schlae/gvpsimm/README.md

# GVP 64-pin SIMM modules

This repository contains reproduction SIMMs for GVP (Great Valley Products)
Amiga accelerator cards. Select a link below to pick a particular version.

[4MB version](4MB/README.md)

[16MB version](16MB/README.md)
