schlae/gvpsimm/4MB/gvpsimm.pdf

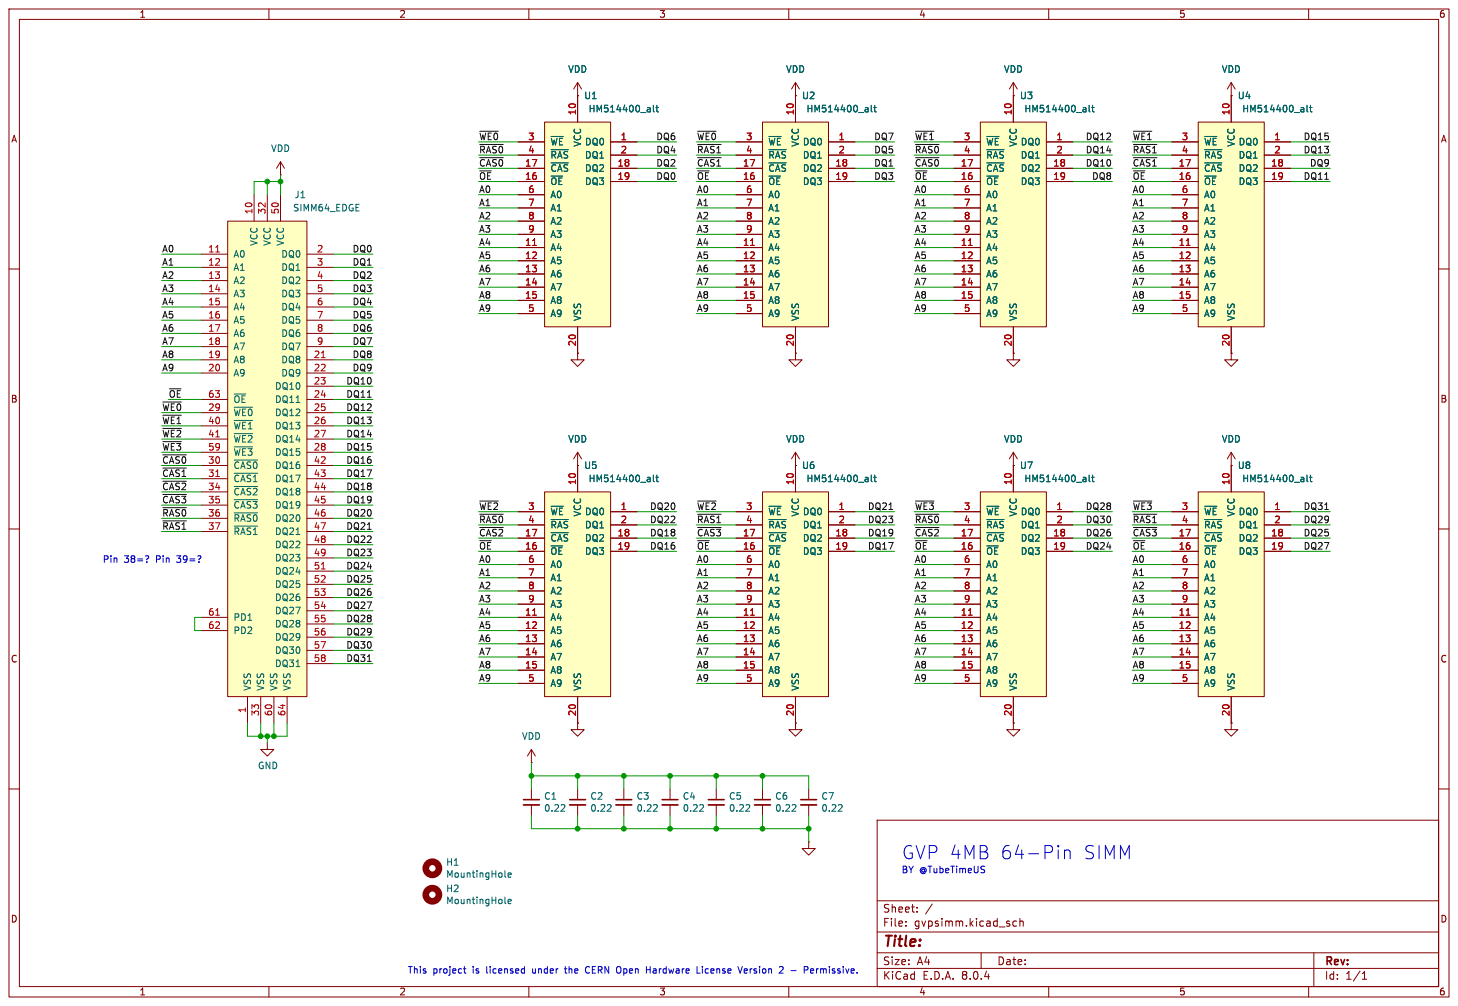
[picture p2: page 1]

Id: 1/1 Title: File: gvpsimm.kicad_sch Sheet: /
