schlae/gvpsimm/16MB/gvpsimm16.kicad_pcb

## KiCad design 16MB/gvpsimm16.kicad_pcb (2025-04-29)

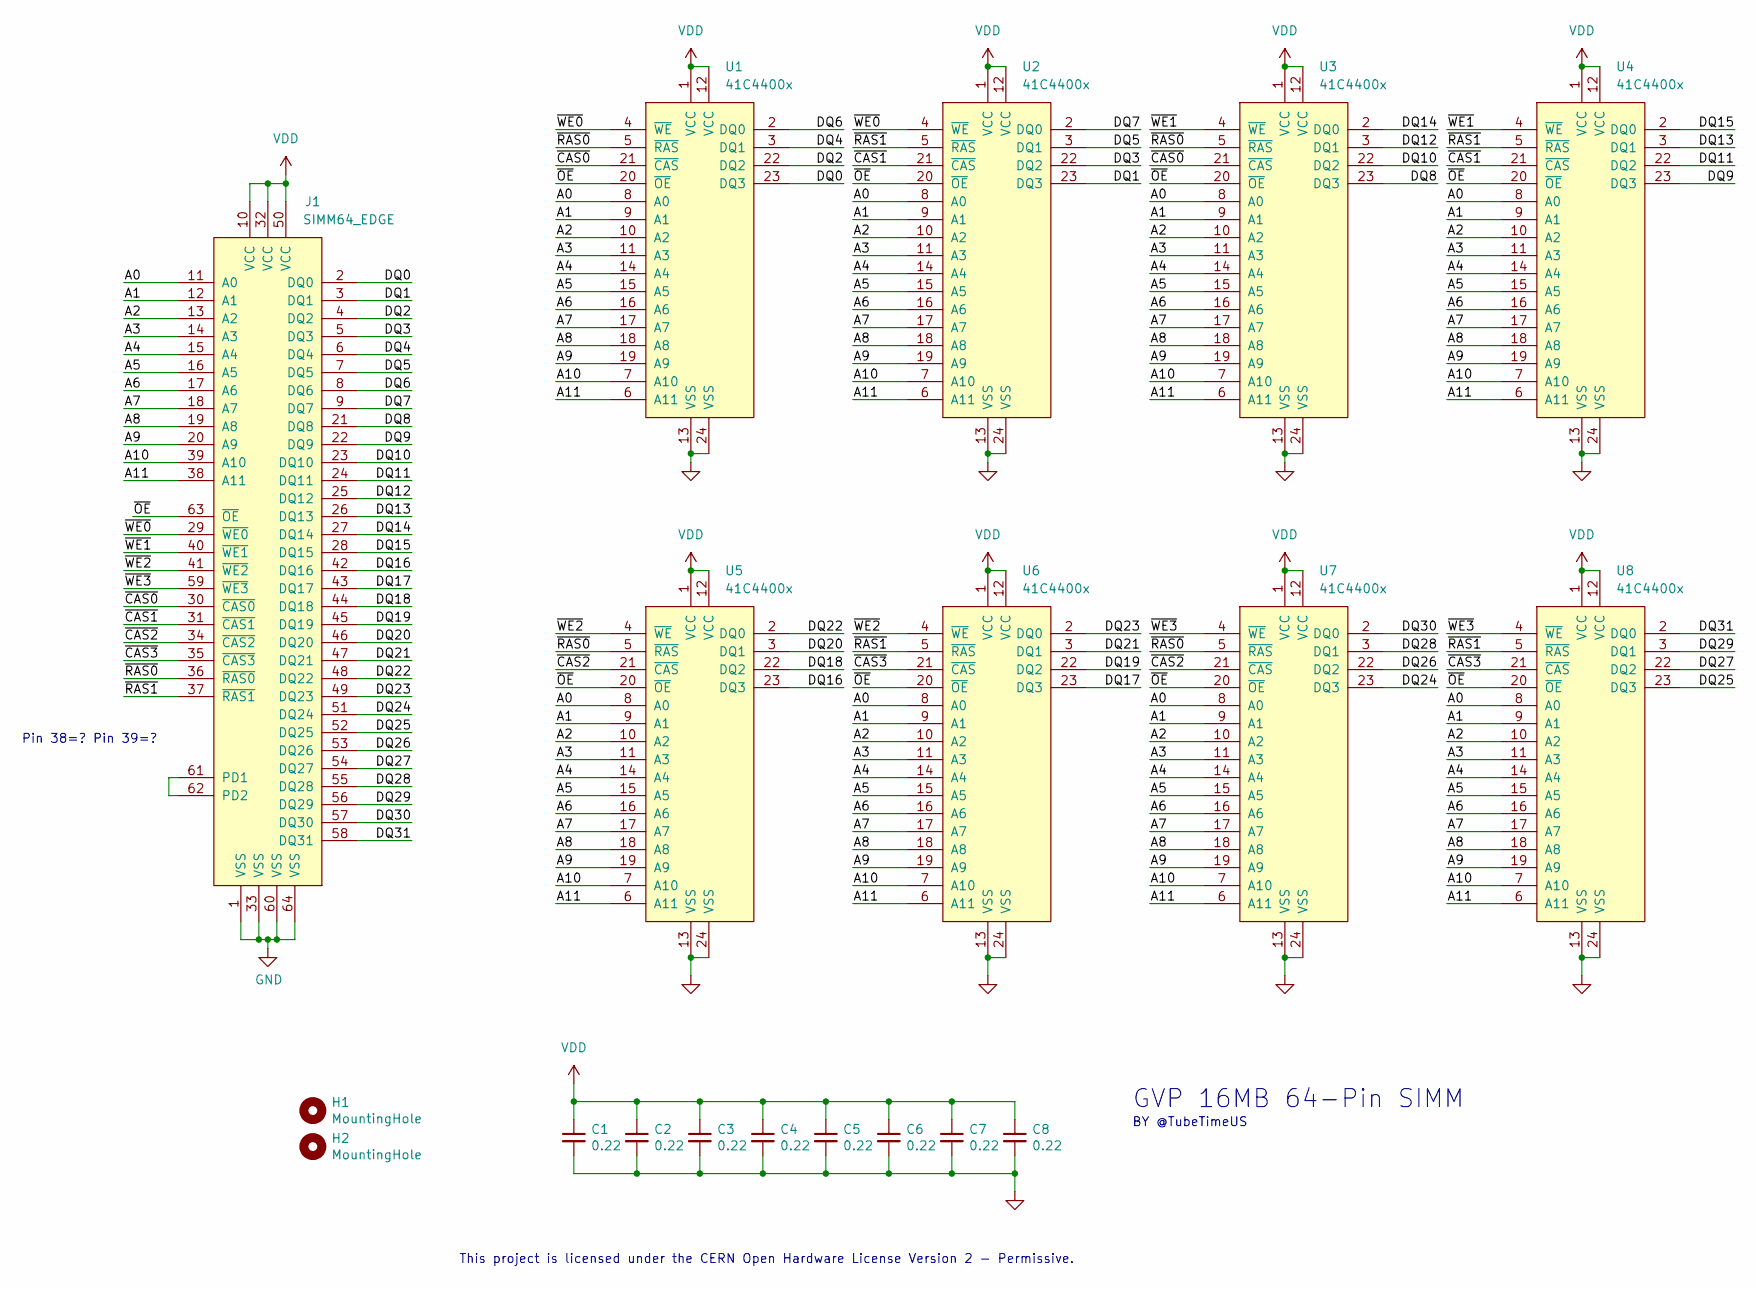
[picture p3: schematic gvpsimm16.kicad_sch]

Parts:
C1, C2, C3, C4, C5, C6, C7, C8: 0.22; CAPC1608X100
H1, H2: MountingHole; MH_125
J1: SIMM64_EDGE; EDGE_SIMM_64_127
U1, U2, U3, U4, U5, U6, U7, U8: 41C4400x; SOJ127P851X356-24

Connections:
/A0: J1.11 (A0), U1.8 (A0), U2.8 (A0), U3.8 (A0), U4.8 (A0), U5.8 (A0), U6.8 (A0), U7.8 (A0), U8.8 (A0)
/A1: J1.12 (A1), U1.9 (A1), U2.9 (A1), U3.9 (A1), U4.9 (A1), U5.9 (A1), U6.9 (A1), U7.9 (A1), U8.9 (A1)
/A2: J1.13 (A2), U1.10 (A2), U2.10 (A2), U3.10 (A2), U4.10 (A2), U5.10 (A2), U6.10 (A2), U7.10 (A2), U8.10 (A2)
/A3: J1.14 (A3), U1.11 (A3), U2.11 (A3), U3.11 (A3), U4.11 (A3), U5.11 (A3), U6.11 (A3), U7.11 (A3), U8.11 (A3)
/A4: J1.15 (A4), U1.14 (A4), U2.14 (A4), U3.14 (A4), U4.14 (A4), U5.14 (A4), U6.14 (A4), U7.14 (A4), U8.14 (A4)
/A5: J1.16 (A5), U1.15 (A5), U2.15 (A5), U3.15 (A5), U4.15 (A5), U5.15 (A5), U6.15 (A5), U7.15 (A5), U8.15 (A5)
/A6: J1.17 (A6), U1.16 (A6), U2.16 (A6), U3.16 (A6), U4.16 (A6), U5.16 (A6), U6.16 (A6), U7.16 (A6), U8.16 (A6)
/A7: J1.18 (A7), U1.17 (A7), U2.17 (A7), U3.17 (A7), U4.17 (A7), U5.17 (A7), U6.17 (A7), U7.17 (A7), U8.17 (A7)
/A8: J1.19 (A8), U1.18 (A8), U2.18 (A8), U3.18 (A8), U4.18 (A8), U5.18 (A8), U6.18 (A8), U7.18 (A8), U8.18 (A8)
/A9: J1.20 (A9), U1.19 (A9), U2.19 (A9), U3.19 (A9), U4.19 (A9), U5.19 (A9), U6.19 (A9), U7.19 (A9), U8.19 (A9)
/A10: J1.39 (A10), U1.7 (A10), U2.7 (A10), U3.7 (A10), U4.7 (A10), U5.7 (A10), U6.7 (A10), U7.7 (A10), U8.7 (A10)
/A11: J1.38 (A11), U1.6 (A11), U2.6 (A11), U3.6 (A11), U4.6 (A11), U5.6 (A11), U6.6 (A11), U7.6 (A11), U8.6 (A11)
/DQ0: J1.2 (DQ0), U1.23 (DQ3)
/DQ1: J1.3 (DQ1), U2.23 (DQ3)
/DQ2: J1.4 (DQ2), U1.22 (DQ2)
/DQ3: J1.5 (DQ3), U2.22 (DQ2)
/DQ4: J1.6 (DQ4), U1.3 (DQ1)
/DQ5: J1.7 (DQ5), U2.3 (DQ1)
/DQ6: J1.8 (DQ6), U1.2 (DQ0)
/DQ7: J1.9 (DQ7), U2.2 (DQ0)
/DQ8: J1.21 (DQ8), U3.23 (DQ3)
/DQ9: J1.22 (DQ9), U4.23 (DQ3)
/DQ10: J1.23 (DQ10), U3.22 (DQ2)
/DQ11: J1.24 (DQ11), U4.22 (DQ2)
/DQ12: J1.25 (DQ12), U3.3 (DQ1)
/DQ13: J1.26 (DQ13), U4.3 (DQ1)
/DQ14: J1.27 (DQ14), U3.2 (DQ0)
/DQ15: J1.28 (DQ15), U4.2 (DQ0)
/DQ16: J1.42 (DQ16), U5.23 (DQ3)
/DQ17: J1.43 (DQ17), U6.23 (DQ3)
/DQ18: J1.44 (DQ18), U5.22 (DQ2)
/DQ19: J1.45 (DQ19), U6.22 (DQ2)
/DQ20: J1.46 (DQ20), U5.3 (DQ1)
/DQ21: J1.47 (DQ21), U6.3 (DQ1)
/DQ22: J1.48 (DQ22), U5.2 (DQ0)
/DQ23: J1.49 (DQ23), U6.2 (DQ0)
/DQ24: J1.51 (DQ24), U7.23 (DQ3)
/DQ25: J1.52 (DQ25), U8.23 (DQ3)
/DQ26: J1.53 (DQ26), U7.22 (DQ2)
/DQ27: J1.54 (DQ27), U8.22 (DQ2)
/DQ28: J1.55 (DQ28), U7.3 (DQ1)
/DQ29: J1.56 (DQ29), U8.3 (DQ1)
/DQ30: J1.57 (DQ30), U7.2 (DQ0)
/DQ31: J1.58 (DQ31), U8.2 (DQ0)
/~CAS0: J1.30 (~CAS0), U1.21 (~CAS), U3.21 (~CAS)
/~CAS1: J1.31 (~CAS1), U2.21 (~CAS), U4.21 (~CAS)
/~CAS2: J1.34 (~CAS2), U5.21 (~CAS), U7.21 (~CAS)
/~CAS3: J1.35 (~CAS3), U6.21 (~CAS), U8.21 (~CAS)
/~OE: J1.63 (~OE), U1.20 (~OE), U2.20 (~OE), U3.20 (~OE), U4.20 (~OE), U5.20 (~OE), U6.20 (~OE), U7.20 (~OE), U8.20 (~OE)
/~RAS0: J1.36 (~RAS0), U1.5 (~RAS), U3.5 (~RAS), U5.5 (~RAS), U7.5 (~RAS)
/~RAS1: J1.37 (~RAS1), U2.5 (~RAS), U4.5 (~RAS), U6.5 (~RAS), U8.5 (~RAS)
/~WE0: J1.29 (~WE0), U1.4 (~WE), U2.4 (~WE)
/~WE1: J1.40 (~WE1), U3.4 (~WE), U4.4 (~WE)
/~WE2: J1.41 (~WE2), U5.4 (~WE), U6.4 (~WE)
/~WE3: J1.59 (~WE3), U7.4 (~WE), U8.4 (~WE)
GND: C1.2, C2.2, C3.2, C4.2, C5.2, C6.2, C7.2, C8.2, J1.1 (VSS), J1.33 (VSS), J1.60 (VSS), J1.64 (VSS), U1.13 (VSS), U1.24 (VSS), U2.13 (VSS), U2.24 (VSS), U3.13 (VSS), U3.24 (VSS), U4.13 (VSS), U4.24 (VSS), U5.13 (VSS), U5.24 (VSS), U6.13 (VSS), U6.24 (VSS), U7.13 (VSS), U7.24 (VSS), U8.13 (VSS), U8.24 (VSS)
unnamed: J1.61 (PD1), J1.62 (PD2)
VDD: C1.1, C2.1, C3.1, C4.1, C5.1, C6.1, C7.1, C8.1, J1.10 (VCC), J1.32 (VCC), J1.50 (VCC), U1.1 (VCC), U1.12 (VCC), U2.1 (VCC), U2.12 (VCC), U3.1 (VCC), U3.12 (VCC), U4.1 (VCC), U4.12 (VCC), U5.1 (VCC), U5.12 (VCC), U6.1 (VCC), U6.12 (VCC), U7.1 (VCC), U7.12 (VCC), U8.1 (VCC), U8.12 (VCC)

Notes on the sheet:
Pin 38=? Pin 39=?
BY @TubeTimeUS
This project is licensed under the CERN Open Hardware License Version 2 - Permissive.
GVP 16MB 64-Pin SIMM

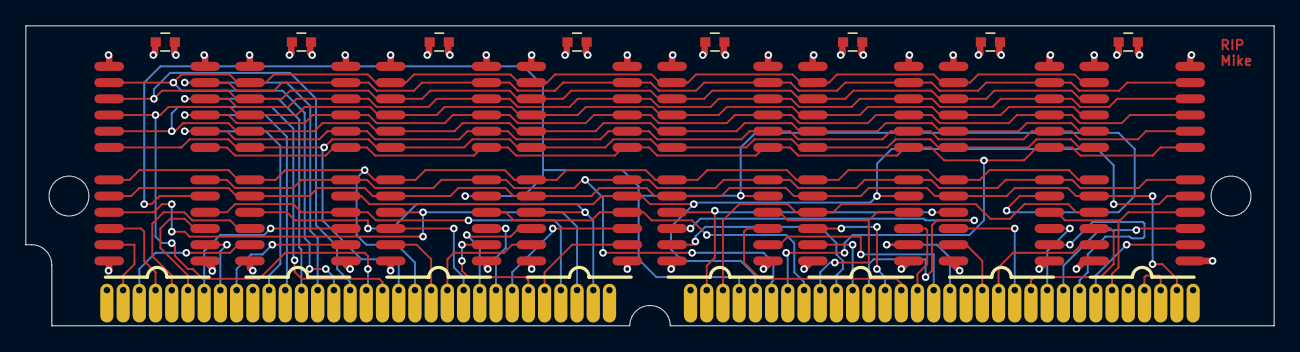
[picture p4: board gvpsimm16.kicad_pcb from above]

Board: 4 copper layers, 97.8 x 23.5 mm, 19 parts (0 on the bottom side), 58 nets.
