schlae/gvpsimm/4MB/gvpsimm.kicad_pcb

## KiCad design 4MB/gvpsimm.kicad_pcb (2025-04-29)

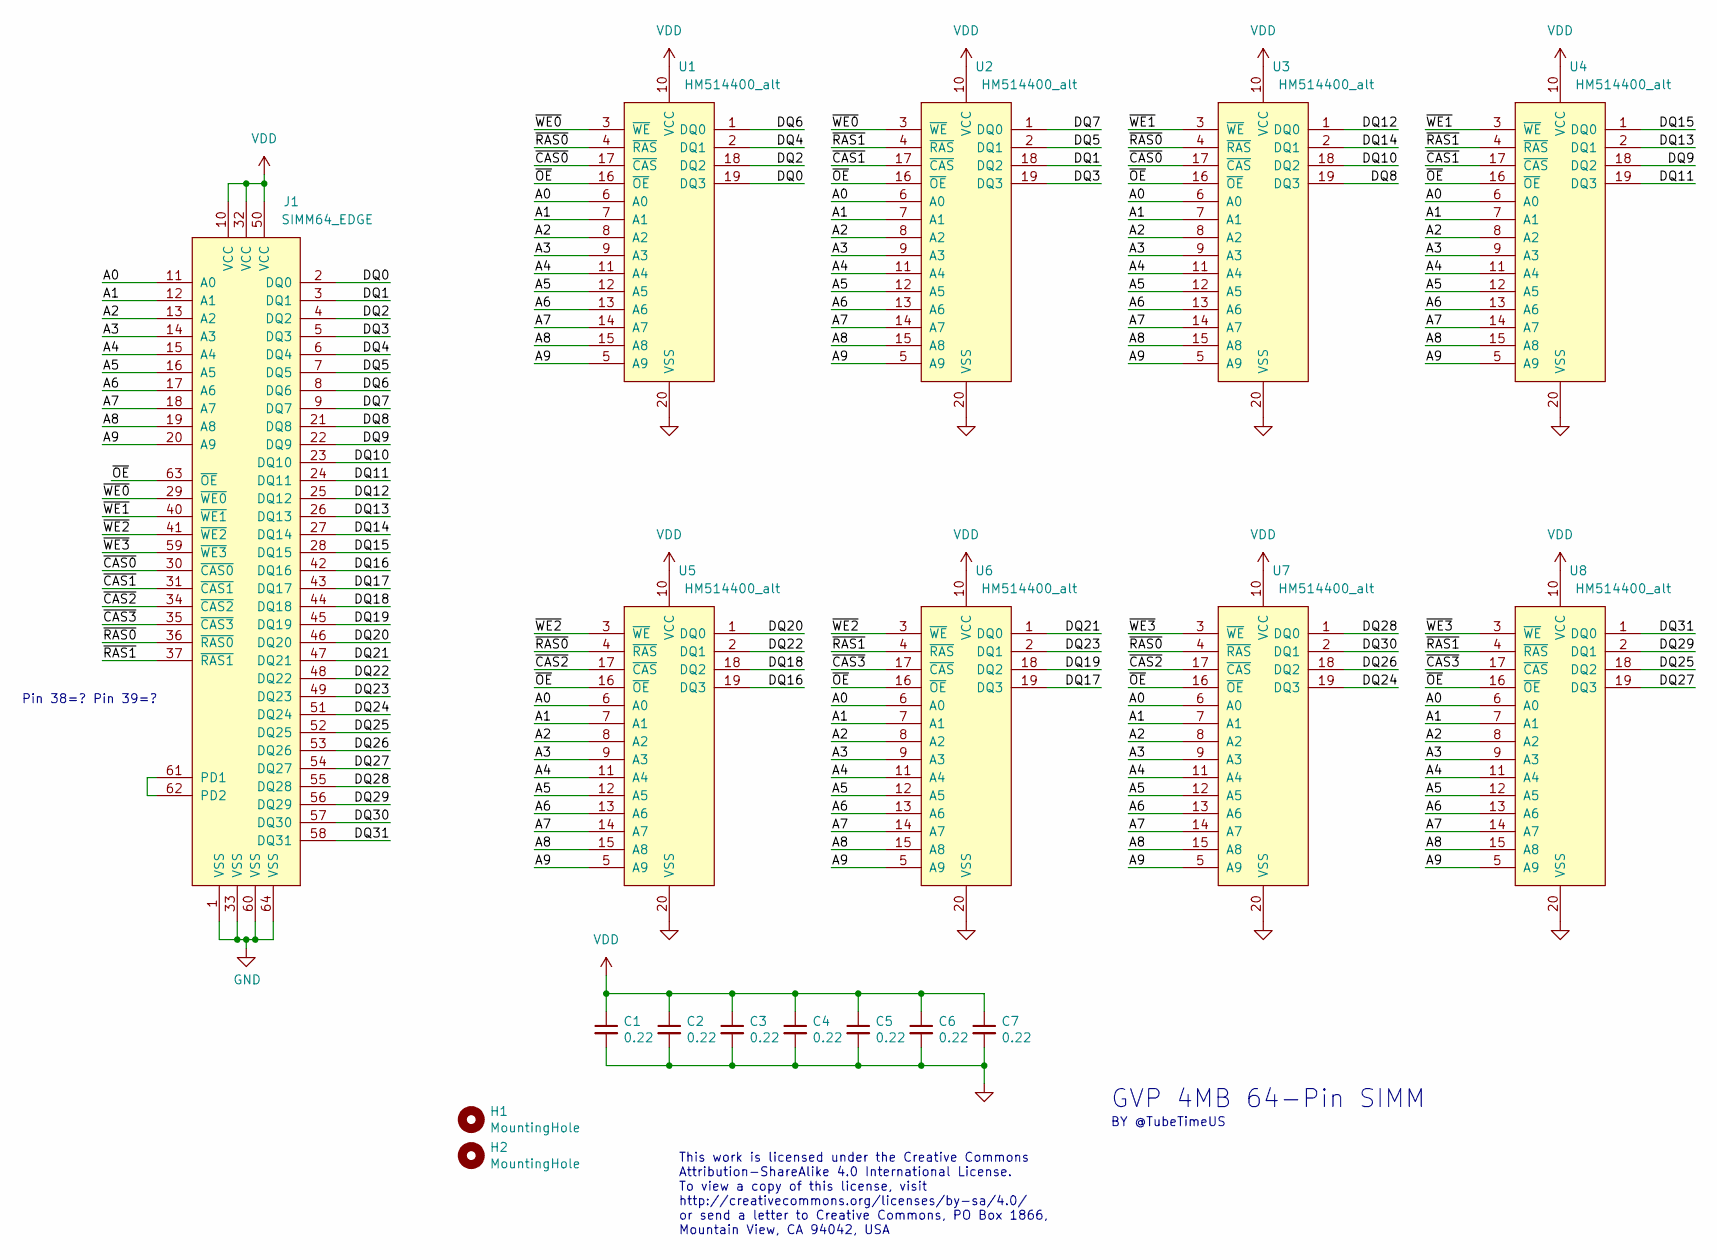
[picture p5: schematic gvpsimm.kicad_sch]

Parts:
C1, C2, C3, C4, C5, C6, C7: 0.22; CAPC1608X100
H1, H2: MountingHole; MH_125
J1: SIMM64_EDGE; EDGE_SIMM_64_127
U1, U2, U3, U4, U5, U6, U7, U8: HM514400_alt; SOJ127P851X356-20_alt; MPN HM514400CS-6 OR EQUIV

Connections:
/A0: J1.11 (A0), U1.6 (A0), U2.6 (A0), U3.6 (A0), U4.6 (A0), U5.6 (A0), U6.6 (A0), U7.6 (A0), U8.6 (A0)
/A1: J1.12 (A1), U1.7 (A1), U2.7 (A1), U3.7 (A1), U4.7 (A1), U5.7 (A1), U6.7 (A1), U7.7 (A1), U8.7 (A1)
/A2: J1.13 (A2), U1.8 (A2), U2.8 (A2), U3.8 (A2), U4.8 (A2), U5.8 (A2), U6.8 (A2), U7.8 (A2), U8.8 (A2)
/A3: J1.14 (A3), U1.9 (A3), U2.9 (A3), U3.9 (A3), U4.9 (A3), U5.9 (A3), U6.9 (A3), U7.9 (A3), U8.9 (A3)
/A4: J1.15 (A4), U1.11 (A4), U2.11 (A4), U3.11 (A4), U4.11 (A4), U5.11 (A4), U6.11 (A4), U7.11 (A4), U8.11 (A4)
/A5: J1.16 (A5), U1.12 (A5), U2.12 (A5), U3.12 (A5), U4.12 (A5), U5.12 (A5), U6.12 (A5), U7.12 (A5), U8.12 (A5)
/A6: J1.17 (A6), U1.13 (A6), U2.13 (A6), U3.13 (A6), U4.13 (A6), U5.13 (A6), U6.13 (A6), U7.13 (A6), U8.13 (A6)
/A7: J1.18 (A7), U1.14 (A7), U2.14 (A7), U3.14 (A7), U4.14 (A7), U5.14 (A7), U6.14 (A7), U7.14 (A7), U8.14 (A7)
/A8: J1.19 (A8), U1.15 (A8), U2.15 (A8), U3.15 (A8), U4.15 (A8), U5.15 (A8), U6.15 (A8), U7.15 (A8), U8.15 (A8)
/A9: J1.20 (A9), U1.5 (A9), U2.5 (A9), U3.5 (A9), U4.5 (A9), U5.5 (A9), U6.5 (A9), U7.5 (A9), U8.5 (A9)
/DQ0: J1.2 (DQ0), U1.19 (DQ3)
/DQ1: J1.3 (DQ1), U2.18 (DQ2)
/DQ2: J1.4 (DQ2), U1.18 (DQ2)
/DQ3: J1.5 (DQ3), U2.19 (DQ3)
/DQ4: J1.6 (DQ4), U1.2 (DQ1)
/DQ5: J1.7 (DQ5), U2.2 (DQ1)
/DQ6: J1.8 (DQ6), U1.1 (DQ0)
/DQ7: J1.9 (DQ7), U2.1 (DQ0)
/DQ8: J1.21 (DQ8), U3.19 (DQ3)
/DQ9: J1.22 (DQ9), U4.18 (DQ2)
/DQ10: J1.23 (DQ10), U3.18 (DQ2)
/DQ11: J1.24 (DQ11), U4.19 (DQ3)
/DQ12: J1.25 (DQ12), U3.1 (DQ0)
/DQ13: J1.26 (DQ13), U4.2 (DQ1)
/DQ14: J1.27 (DQ14), U3.2 (DQ1)
/DQ15: J1.28 (DQ15), U4.1 (DQ0)
/DQ16: J1.42 (DQ16), U5.19 (DQ3)
/DQ17: J1.43 (DQ17), U6.19 (DQ3)
/DQ18: J1.44 (DQ18), U5.18 (DQ2)
/DQ19: J1.45 (DQ19), U6.18 (DQ2)
/DQ20: J1.46 (DQ20), U5.1 (DQ0)
/DQ21: J1.47 (DQ21), U6.1 (DQ0)
/DQ22: J1.48 (DQ22), U5.2 (DQ1)
/DQ23: J1.49 (DQ23), U6.2 (DQ1)
/DQ24: J1.51 (DQ24), U7.19 (DQ3)
/DQ25: J1.52 (DQ25), U8.18 (DQ2)
/DQ26: J1.53 (DQ26), U7.18 (DQ2)
/DQ27: J1.54 (DQ27), U8.19 (DQ3)
/DQ28: J1.55 (DQ28), U7.1 (DQ0)
/DQ29: J1.56 (DQ29), U8.2 (DQ1)
/DQ30: J1.57 (DQ30), U7.2 (DQ1)
/DQ31: J1.58 (DQ31), U8.1 (DQ0)
/~CAS0: J1.30 (~CAS0), U1.17 (~CAS), U3.17 (~CAS)
/~CAS1: J1.31 (~CAS1), U2.17 (~CAS), U4.17 (~CAS)
/~CAS2: J1.34 (~CAS2), U5.17 (~CAS), U7.17 (~CAS)
/~CAS3: J1.35 (~CAS3), U6.17 (~CAS), U8.17 (~CAS)
/~OE: J1.63 (~OE), U1.16 (~OE), U2.16 (~OE), U3.16 (~OE), U4.16 (~OE), U5.16 (~OE), U6.16 (~OE), U7.16 (~OE), U8.16 (~OE)
/~RAS0: J1.36 (~RAS0), U1.4 (~RAS), U3.4 (~RAS), U5.4 (~RAS), U7.4 (~RAS)
/~RAS1: J1.37 (~RAS1), U2.4 (~RAS), U4.4 (~RAS), U6.4 (~RAS), U8.4 (~RAS)
/~WE0: J1.29 (~WE0), U1.3 (~WE), U2.3 (~WE)
/~WE1: J1.40 (~WE1), U3.3 (~WE), U4.3 (~WE)
/~WE2: J1.41 (~WE2), U5.3 (~WE), U6.3 (~WE)
/~WE3: J1.59 (~WE3), U7.3 (~WE), U8.3 (~WE)
GND: C1.2, C2.2, C3.2, C4.2, C5.2, C6.2, C7.2, J1.1 (VSS), J1.33 (VSS), J1.60 (VSS), J1.64 (VSS), U1.20 (VSS), U2.20 (VSS), U3.20 (VSS), U4.20 (VSS), U5.20 (VSS), U6.20 (VSS), U7.20 (VSS), U8.20 (VSS)
unnamed: J1.61 (PD1), J1.62 (PD2)
VDD: C1.1, C2.1, C3.1, C4.1, C5.1, C6.1, C7.1, J1.10 (VCC), J1.32 (VCC), J1.50 (VCC), U1.10 (VCC), U2.10 (VCC), U3.10 (VCC), U4.10 (VCC), U5.10 (VCC), U6.10 (VCC), U7.10 (VCC), U8.10 (VCC)

Notes on the sheet:
Pin 38=? Pin 39=?
BY @TubeTimeUS
This work is licensed under the Creative Commons Attribution-ShareAlike 4.0 International License. To view a copy of this license, visit http://creativecommons.org/licenses/by-sa/4.0/ or send a letter to Creative Commons, PO Box 1866, Mountain View, CA 94042, USA
GVP 4MB 64-Pin SIMM

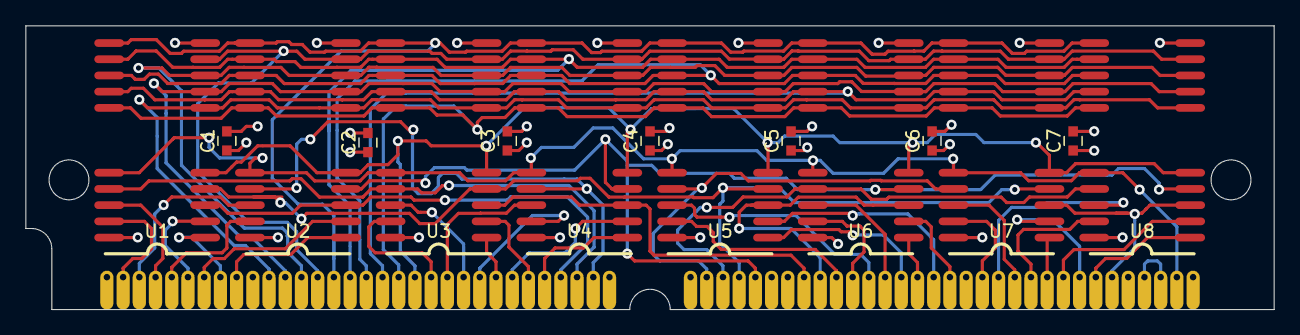
[picture p6: board gvpsimm.kicad_pcb from above]

Board: 4 copper layers, 97.8 x 22.2 mm, 18 parts (0 on the bottom side), 56 nets.
