schlae/gvpsimm/(threads)

Thread 1 (2021-10-10):

16MB SIMM possibilities?

hexbus, 2021-10-10:
Would it be possible to get a PCB for the 16MB SIMMS?  Thanks for your work on these!

greukik, 2024-11-30:
Hello. Was asking also if changing for 4096kword x 4bit could work for a 16Mb simm ?

schlae, 2024-12-02:
I'd like to design a 16MB SIMM, but I don't have any way of testing it. In principle it should be relatively simple.

mariuszk911, 2024-12-02:
Please do, my javs2 and Combo040 desperately need them :)

pon., 2 gru 2024, 19:08 użytkownik Tube Time ***@***.***>
napisał:

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

schlae, 2024-12-02:
If any of you know someone who owns a 16MB SIMM, it would be helpful to get a scan of the front and back.

mariuszk911, 2024-12-02:
ill try to send You scans/pictures later today.

pon., 2 gru 2024, 19:26 użytkownik Tube Time ***@***.***>
napisał:

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

Mavideoart, 2025-04-26:
Is there a 16mb sims version available?

schlae, 2025-04-28:
Nobody has sent any photos, and since I don't have any GVP devices that use the 16MB SIMMS, there's no way I can deduce the pin connections.

Mavideoart, 2025-04-29:
Let me help you with some pictures of gvp 64n pin 16mb sim. The ram used on
this board is HYB5116400BJ-60. If you need more detailed scans please
advise. I look forward to you response.

Kind Regards

Michael Mavracic

 img20250423_22011149.tif
<https://drive.google.com/file/d/1O9xaWyK6VZMb0M_FLwEO1K5OgBvtprb1/view?usp=drive_web>
 img20250423_22135631.tif
<https://drive.google.com/file/d/17l7UcCNk0FTB97t67UwkaaRJ9VdIht5s/view?usp=drive_web>

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

schlae, 2025-04-29:
16MB version (beta) is now available.

Closed 2025-04-29.
