schlae/gvpsimm/(commit log)

2025-04-29 Update to KiCad 8
    [gvpsimm.kicad_pcb, gvpsimm.kicad_sch, gvpsimm.sch]
2025-04-29 Organize repository
    [gvpsimm.kicad_pcb, gvpsimm.kicad_sch]
2025-04-29 Modify license
    [gvpsimm.kicad_sch]
2025-04-29 Added 16MB beta version
    [gvpsimm16.kicad_pcb, gvpsimm16.kicad_sch]
