schlae/gvpsimm/(notices)

Notices in the files:
16MB/gvpsimm16.kicad_pcb:
© 2025 TUBETIMEUS
4MB/gvpsimm.kicad_pcb:
© 2019 TUBETIMEUS
